IliaRakhlevski/STM32-Road-Impact-Detector/Docs/Images/icm-20948-breakout-back.jpg

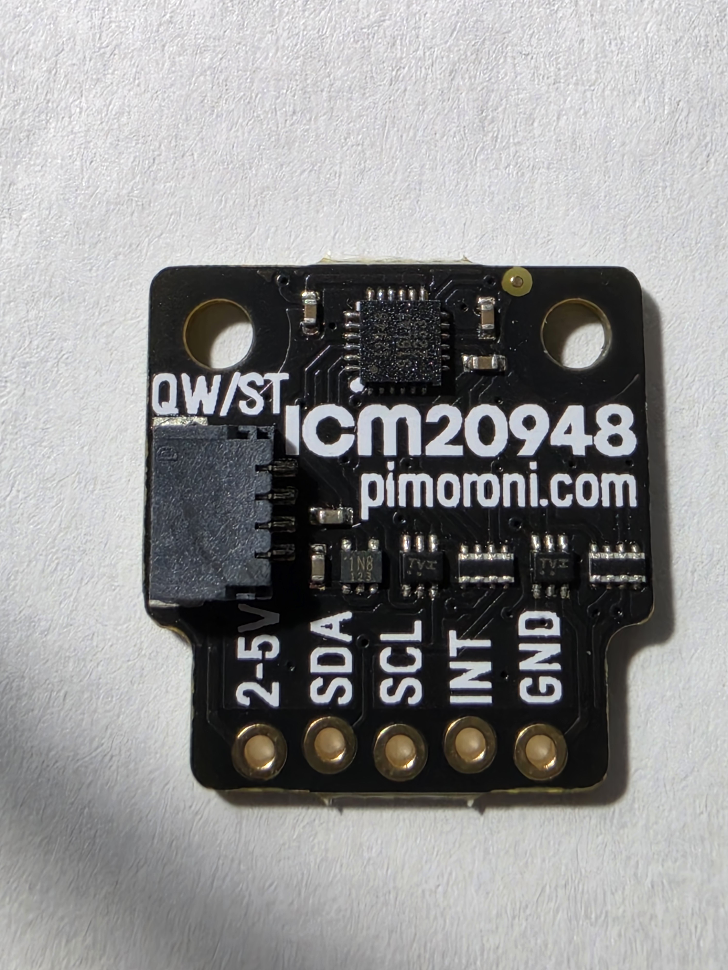
Docs/Images/icm-20948-breakout-back.jpg
