IliaRakhlevski/STM32-Road-Impact-Detector/Docs/Images/overview.png

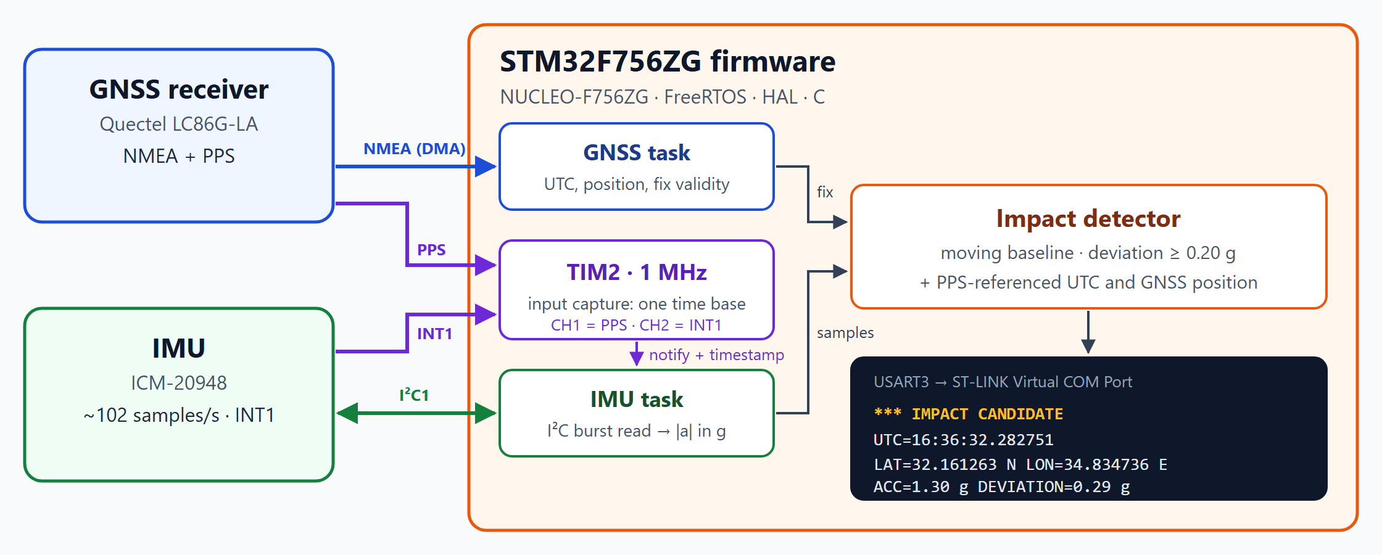
Docs/Images/overview.png
