IliaRakhlevski/STM32-Road-Impact-Detector/Docs/Images/quectel-l80-gnss-board-back.jpg

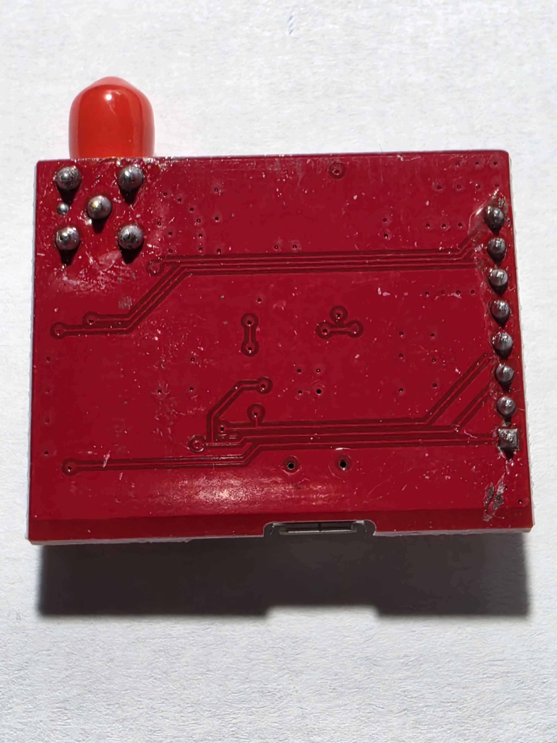
Docs/Images/quectel-l80-gnss-board-back.jpg
