IliaRakhlevski/STM32-Road-Impact-Detector/STM32RoadImpactDetector/STM32RoadImpactDetector.ioc

Mcu.UserName=STM32F756ZGTx
PA0/WKUP.Signal=S_TIM2_CH1_ETR
PA13.Signal=SYS_JTMS-SWDIO
PA14.Signal=SYS_JTCK-SWCLK
PB3.Signal=S_TIM2_CH2
PB8.Signal=I2C1_SCL
PB9.Signal=I2C1_SDA
PD5.Signal=USART2_TX
PD6.Signal=USART2_RX
PD8.Signal=USART3_TX
PD9.Signal=USART3_RX
PH0/OSC_IN.Signal=RCC_OSC_IN
PH1/OSC_OUT.Signal=RCC_OSC_OUT
