IliaRakhlevski/STM32-Road-Impact-Detector/STM32RoadImpactDetector/Core/Application/Src/gnss.c

/**
 * @file gnss.c
 * @brief GNSS module implementation.
 */

#include "gnss.h"

#include "console.h"
#include "time_capture.h"
#include "usart.h"

#include "FreeRTOS.h"
#include "task.h"

#include <stdio.h>
#include <stdint.h>
#include <string.h>

/** Size of the circular USART2 DMA receive buffer. */
#define GNSS_RX_DMA_BUFFER_SIZE 1024U

/** Maximum length of one NMEA sentence, including line termination. */
#define GNSS_NMEA_SENTENCE_SIZE 128U

/** Maximum accepted age of a GNSS fix relative to an IMU capture. */
#define GNSS_MAX_CAPTURE_OFFSET_US 2000000U

/**
 * @brief Indices of the GGA fields used by the parser.
 */
typedef enum
{
    GNSS_GGA_FIELD_MESSAGE = 0,
    GNSS_GGA_FIELD_TIME,
    GNSS_GGA_FIELD_LATITUDE,
    GNSS_GGA_FIELD_LATITUDE_DIRECTION,
    GNSS_GGA_FIELD_LONGITUDE,
    GNSS_GGA_FIELD_LONGITUDE_DIRECTION,
    GNSS_GGA_FIELD_FIX_QUALITY,
    GNSS_GGA_FIELD_COUNT
} GNSS_GgaFieldIndex;

/** Circular DMA buffer used to receive GNSS NMEA data. */
static uint8_t gnss_rx_dma_buffer[GNSS_RX_DMA_BUFFER_SIZE];

/** Buffer used to assemble one complete NMEA sentence. */
static char gnss_nmea_sentence[GNSS_NMEA_SENTENCE_SIZE];

/** Handle of the task responsible for GNSS communication and processing. */
static TaskHandle_t gnss_task_handle;

/** Current USART2 DMA write position reported by the HAL callback. */
static volatile uint16_t gnss_dma_write_position;

/** Current write position in the NMEA sentence buffer. */
static uint16_t gnss_nmea_position;

/** Indicates that an NMEA sentence is currently being assembled. */
static bool gnss_nmea_active;

/** Latest valid GNSS position associated with a PPS edge. */
static GNSS_Fix gnss_latest_fix;

/** Valid GNSS position preceding the latest position. */
static GNSS_Fix gnss_previous_fix;

/**
 * @brief Parse a complete GGA sentence and print valid coordinates.
 *
 * The GNSS module outputs position data as NMEA 0183 ASCII sentences. A
 * standard sentence starts with '$', contains comma-separated fields, ends
 * with a checksum after '*', and is terminated by <CR><LF>.
 *
 * GGA (Global Positioning System Fix Data) contains the UTC fix time,
 * latitude, longitude, fix quality, number of satellites used, HDOP,
 * altitude and geoid separation.
 *
 * The two characters before GGA are the NMEA talker ID:
 * - $GNGGA reports a fix calculated from multiple GNSS constellations.
 * - $GPGGA reports a fix identified with the GPS talker ID.
 * Both variants have the same GGA field layout and are accepted here.
 *
 * Example:
 * $GNGGA,040143.000,3149.334166,N,11706.941670,E,2,36,0.48,61.496,M,-0.335,M,,*58
 *          UTC        latitude  N   longitude  E fix sats HDOP altitude
 *
 * See Sections 2.1 and 2.2.2, document pages 14-15 and 18-20:
 * https://www.quectel.com/content/uploads/2024/04/Quectel_LC26GLC26G-TLC76GLC86G_Series_GNSS_Protocol_Specification_V1.5.pdf
 *
 * @param sentence Null-terminated NMEA sentence.
 */
static void GNSS_ParseGga(char *sentence)
{
    char *fields[GNSS_GGA_FIELD_COUNT];
    GNSS_Fix new_fix = {0};
    TimeCapture_Event pps = {0};
    uint8_t field_count = 1U;

    if ((strncmp(sentence, "$GNGGA,", 7U) != 0) &&
        (strncmp(sentence, "$GPGGA,", 7U) != 0))
    {
        return;
    }

    fields[0] = sentence;

    for (char *character = sentence; (*character != '\0') && (field_count < GNSS_GGA_FIELD_COUNT); character++)
    {
        if (*character == ',')
        {
            *character = '\0';
            fields[field_count] = character + 1;
            field_count++;
        }
    }

    if (field_count < GNSS_GGA_FIELD_COUNT)
    {
        return;
    }

    /*
     * Fix quality 0 means that the GGA sentence is valid, but the receiver
     * does not currently have a usable GNSS position fix.
     */
    if (fields[GNSS_GGA_FIELD_FIX_QUALITY][0] == '0')
    {
        return;
    }

    /*
     * A valid position requires both coordinates and their hemisphere
     * indicators. Reject an incomplete GGA sentence before copying its fields.
     */
    if ((fields[GNSS_GGA_FIELD_LATITUDE][0] == '\0') ||
        (fields[GNSS_GGA_FIELD_LATITUDE_DIRECTION][0] == '\0') ||
        (fields[GNSS_GGA_FIELD_LONGITUDE][0] == '\0') ||
        (fields[GNSS_GGA_FIELD_LONGITUDE_DIRECTION][0] == '\0'))
    {
        return;
    }

    strncpy(new_fix.utc_time, fields[GNSS_GGA_FIELD_TIME], GNSS_UTC_TIME_SIZE - 1U);
    strncpy(new_fix.latitude, fields[GNSS_GGA_FIELD_LATITUDE], GNSS_COORDINATE_SIZE - 1U);
    strncpy(new_fix.longitude, fields[GNSS_GGA_FIELD_LONGITUDE], GNSS_COORDINATE_SIZE - 1U);
    new_fix.latitude_direction = fields[GNSS_GGA_FIELD_LATITUDE_DIRECTION][0];
    new_fix.longitude_direction = fields[GNSS_GGA_FIELD_LONGITUDE_DIRECTION][0];

    new_fix.valid = TimeCapture_GetPps(&pps);
    new_fix.pps_capture = pps.capture;
    new_fix.pps_sequence = pps.sequence;

    taskENTER_CRITICAL();
    gnss_previous_fix = gnss_latest_fix;
    gnss_latest_fix = new_fix;
    taskEXIT_CRITICAL();

}

/**
 * @brief Add one received byte to the current NMEA sentence.
 *
 * @param received_byte Byte received from the GNSS module.
 */
static void GNSS_ProcessByte(uint8_t received_byte)
{
    if (received_byte == (uint8_t)'$')
    {
        gnss_nmea_position = 0U;
        gnss_nmea_active = true;
    }

    if (!gnss_nmea_active)
    {
        return;
    }

    if (gnss_nmea_position >= (GNSS_NMEA_SENTENCE_SIZE - 1U))
    {
        gnss_nmea_position = 0U;
        gnss_nmea_active = false;
        return;
    }

    gnss_nmea_sentence[gnss_nmea_position] = (char)received_byte;
    gnss_nmea_position++;

    if (received_byte == (uint8_t)'\n')
    {
        gnss_nmea_sentence[gnss_nmea_position] = '\0';
        gnss_nmea_position = 0U;
        gnss_nmea_active = false;
        GNSS_ParseGga(gnss_nmea_sentence);
    }
}

/**
 * @brief Process a contiguous section of the GNSS DMA buffer.
 *
 * @param start_position Index of the first byte to print.
 * @param end_position Index immediately after the final byte to process.
 */
static void GNSS_ProcessDmaSection(uint16_t start_position, uint16_t end_position)
{
    for (uint16_t position = start_position; position < end_position; position++)
    {
        GNSS_ProcessByte(gnss_rx_dma_buffer[position]);
    }
}

/**
 * @brief Run the GNSS communication task.
 *
 * Starts continuous USART2 DMA reception. Received GGA sentences are parsed
 * to extract valid GNSS coordinates.
 *
 * @param argument Unused task argument.
 */
static void GNSS_Task(void *argument)
{
    uint16_t dma_read_position = 0U;
    uint16_t dma_write_position;

    (void)argument;

    Console_Printf("GNSS: starting UART DMA reception\r\n");

    if (HAL_UARTEx_ReceiveToIdle_DMA(&huart2, gnss_rx_dma_buffer, GNSS_RX_DMA_BUFFER_SIZE) != HAL_OK)
    {
        Console_Printf("GNSS: failed to start UART DMA reception\r\n");
        vTaskDelete(NULL);
        return;
    }

    Console_Printf("GNSS: UART DMA reception started successfully\r\n");

    for (;;)
    {
        (void)ulTaskNotifyTake(pdTRUE, portMAX_DELAY);
        dma_write_position = gnss_dma_write_position;

        if (dma_write_position == dma_read_position)
        {
            continue;
        }

        if (dma_write_position > dma_read_position)
        {
            GNSS_ProcessDmaSection(dma_read_position, dma_write_position);
        }
        else
        {
            GNSS_ProcessDmaSection(dma_read_position, GNSS_RX_DMA_BUFFER_SIZE);
            GNSS_ProcessDmaSection(0U, dma_write_position);
        }

        dma_read_position = dma_write_position;
    }
}

/**
 * @brief Create the task responsible for GNSS operation.
 *
 * @return true if the GNSS task was created successfully; otherwise false.
 */
bool GNSS_Init(void)
{
    return (xTaskCreate(GNSS_Task,
                        "GNSS",
                        512U,
                        NULL,
                        tskIDLE_PRIORITY + 1U,
                        &gnss_task_handle) == pdPASS);
}

/**
 * @brief Find the most recent GNSS fix preceding a TIM2 capture.
 *
 * Unsigned subtraction also handles a TIM2 counter overflow. Both the GNSS
 * PPS and IMU interrupt are captured by the same 1 MHz TIM2 counter, so the
 * resulting difference is expressed in microseconds.
 *
 * @param capture TIM2 capture value of the IMU event.
 * @param fix Pointer to the destination GNSS fix.
 * @param offset_us Pointer to the event offset after PPS in microseconds.
 * @return true if a suitable GNSS fix was found; otherwise false.
 */
bool GNSS_GetFixForCapture(uint32_t capture, GNSS_Fix *fix, uint32_t *offset_us)
{
    GNSS_Fix latest;
    GNSS_Fix previous;
    uint32_t latest_offset;
    uint32_t previous_offset;

    if ((fix == NULL) || (offset_us == NULL))
    {
        return false;
    }

    taskENTER_CRITICAL();
    latest = gnss_latest_fix;
    previous = gnss_previous_fix;
    taskEXIT_CRITICAL();

    latest_offset = capture - latest.pps_capture;
    previous_offset = capture - previous.pps_capture;

    if (latest.valid && (latest_offset <= GNSS_MAX_CAPTURE_OFFSET_US))
    {
        *fix = latest;
        *offset_us = latest_offset;
        return true;
    }

    if (previous.valid && (previous_offset <= GNSS_MAX_CAPTURE_OFFSET_US))
    {
        *fix = previous;
        *offset_us = previous_offset;
        return true;
    }

    return false;
}

/**
 * @brief Handle a USART receive-to-idle DMA event.
 *
 * For circular DMA reception, Size is the current write position inside the
 * DMA buffer. The GNSS task compares it with its previous read position and
 * handles counter wraparound.
 *
 * @param huart Pointer to the UART handle that generated the event.
 * @param Size Current DMA write position.
 */
void HAL_UARTEx_RxEventCallback(UART_HandleTypeDef *huart, uint16_t Size)
{
    BaseType_t higher_priority_task_woken = pdFALSE;

    if ((huart == NULL) || (huart->Instance != USART2))
    {
        return;
    }

    if (Size > GNSS_RX_DMA_BUFFER_SIZE)
    {
        return;
    }

    if (Size == GNSS_RX_DMA_BUFFER_SIZE)
    {
        gnss_dma_write_position = 0U;
    }
    else
    {
        gnss_dma_write_position = Size;
    }

    vTaskNotifyGiveFromISR(gnss_task_handle, &higher_priority_task_woken);
    portYIELD_FROM_ISR(higher_priority_task_woken);
}
