IliaRakhlevski/STM32-Road-Impact-Detector/(commit log)

2026-07-27 Initialize STM32 FreeRTOS project
    - Add initial STM32CubeIDE project for NUCLEO-F756ZG
    - Configure FreeRTOS, HSE system clock, TIM6 HAL time base, and USART3 diagnostics
    - Add project README and architectural design decisions
    - Add hardware documentation images
2026-07-28 Implement GNSS and IMU data acquisition
    Add PPS and IMU interrupt timestamp capture, GNSS UART DMA reception, GNGGA parsing, interrupt-driven ICM-20948 acquisition, acceleration conversion, I2C recovery, and updated architecture documentation.
2026-07-30 Add synchronized impact candidate detection
    - Add GNSS reception and NMEA GGA parsing using UART DMA.
    - Capture GNSS PPS and IMU interrupt timestamps with TIM2.
    - Synchronize IMU measurements with GNSS UTC time and coordinates.
    - Add moving-baseline acceleration analysis for impact candidate detection.
    - Add thread-safe USART3 console output using a FreeRTOS mutex.
    - Add IMU communication recovery after I2C read failures.
    - Update the README and architectural design decisions documentation.
    [app_main.c, console.c, console.h, gnss.c, gnss.h, impact_detector.c, impact_detector.h, imu.c]
2026-07-31 Refine sensor diagnostics and detection documentation
    - Add detailed comments and datasheet references for ICM-20948 configuration, identification, burst reads, and acceleration conversion.
    - Document NMEA GGA structure and the GNGGA/GPGGA talker identifiers.
    - Reduce verbose GNSS diagnostic output.
    - Add periodic synchronized GNSS/IMU status reporting with decimal-degree coordinates.
    - Improve impact candidate diagnostic output and report the current moving baseline.
    - Expand the architectural documentation with the complete impact candidate detection flow, assumptions, and limitations.
2026-07-31 Clarify sensor timing architecture documentation
    Refine the project scope around IMU acquisition, GNSS timing, and impact candidate detection. Document the shared TIM2 capture path for GNSS PPS and the ICM-20948 INT1 signal. Add official clock-source references, distinguish completed PPS synchronization from future TIM2 frequency correction, and include prototype photographs for later documentation use.
2026-08-01 Add system architecture and field-test documentation
    Expand the README with the system architecture, current implementation, impact-candidate detection algorithm, hardware connections, and build instructions.
    Add an architecture diagram showing the GNSS, IMU, TIM2, FreeRTOS task, impact-detector, and diagnostic-output data flows.
    Add the outdoor field-test video and captured diagnostic output.
    Document the STATUS and IMPACT CANDIDATE messages using real test data.
    Integrate the prototype photographs and add official hardware documentation references.
2026-08-01 Document sensor power connections and GNSS references
    Document the 3.3 V supply connections for the GNSS and IMU boards.
    Warn against connecting the HW-658 VCC input to 5 V and record the LC86G-LA supply limits.
    Add links to the official Quectel hardware design and GNSS protocol specifications.
2026-08-01 Document GNSS module identification
    Explain that the L80-M39-marked HW-658 board identifies itself as an LC86G-LA through UART.
    Record the installed firmware version, PAIR protocol behavior, and missing PAIR751 support.
    Emphasize the requirement to power the GNSS board from the NUCLEO 3V3 output.
2026-08-03 Move impact detector parameters to configuration header
    - Add impact_detector_config.h for impact detection parameters
    - Move averaging, threshold, baseline update, candidate completion, and timer frequency values out of impact_detector.c
    - Keep the detector behavior unchanged while making its parameters easier to configure
2026-11-09 Add compact overview diagram
    High-level picture of the GNSS and IMU signal paths, the shared TIM2
    time base and the impact detector for the GitHub profile showcase.
