IliaRakhlevski/STM32-Road-Impact-Detector/Docs/Images/road-impact-detector-prototype-top-view.jpg

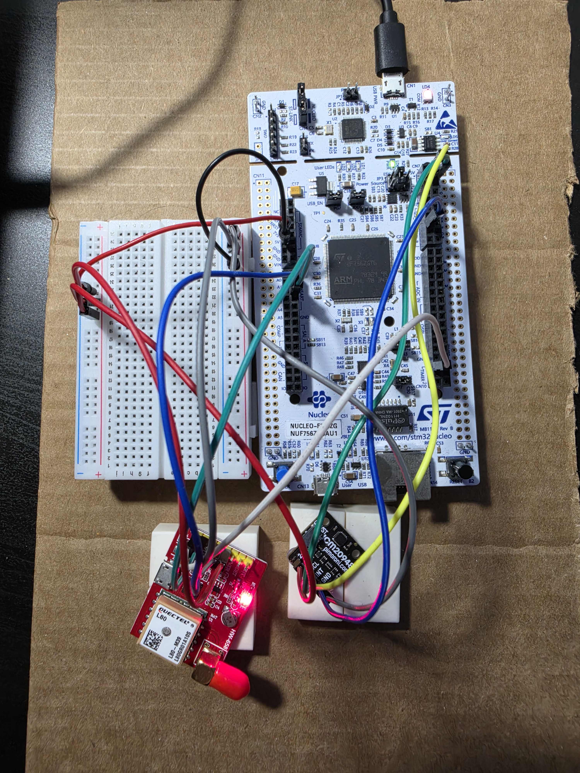
[picture p6: Docs/Images/road-impact-detector-prototype-top-view.jpg]
Docs/Images/road-impact-detector-prototype-top-view.jpg
